arhefner/1802-Mini-PIO/README.md

# 1802-Mini-PIO
Parallel Expansion Board for the 1802/Mini Computer
