arhefner/1802-Mini-PIO/notes/1802-Mini-PIO-BOM.xlsx

Please refer to these notes as applicable for the parts list below:
*A | The Samtec 39 pin connector, when ordering from Digikey, will always show zero stock because they are made-to-order. They will ship same or next day though.
*B | These parts may be omitted if group port selection will not be used. See assembly notes.
*C | Use the long tail headers for stacked assembly, and the right-angle headers if installing on a base board with a group I/O cable
PARALLEL INTERFACE
Qty | Description |  | Manufacturer | Manufacturer # | Vendor | Vendor # | Price | Qty | Total
Integrated Circuits
2 | 74HC04 | U1,U8 | TI | SN74HC04N | Mouser | 595-SN74HC04N | 0.62 | 2.00 | 1.24
1 | 74HC00 | U2 | TI | SN74HC00N | Mouser | 595-SN74HC00N | 0.60 | 1.00 | 0.60
1 | 74HC238 | U3 | TI | CD74HC238E | Mouser | 595-CD74HC238E | 0.70 | 1.00 | 0.70
1 | 74HC11 | U4 | TI | SN74HC11N | Mouser | 595-SN74HC11N | 0.60 | 1.00 | 0.60
2 | 74HC273 | U5,U6 | TI | SN74HC273N | Mouser | 595-SN74HC273N | 0.93 | 2.00 | 1.86
1 | 74HC573 | U7 | TI | SN74HC573AN | Mouser | 595-SN74HC573AN | 0.94 | 1.00 | 0.94
2 | 74HC74 | U9,U11 | TI | SN74HC74N | Mouser | 595-SN74HC74N | 0.60 | 2.00 | 1.20
1 | 74HC08 | U10 | TI | SN74HC08N | Mouser | 595-SN74HC08N | 0.60 | 1.00 | 0.60
2 | 74HC4050 | U12,U13 | TI | CD74HC4050E | Mouser | 595-CD74HC4050E | 0.67 | 2.00 | 1.34
Discrete Components
8 | Diode 1N4148 | D1-D8 | ON Semi | 1N4148 | Mouser | 512-1N4148 | 0.10 | 8.00 | 0.80
13 | Ceramic capacitor 0.1uF radial 0.2" | C1-13 | Vishay | K104K10X7RF5UH5 | Digikey | BC2665CT-ND | 0.16 | 13.00 | 2.03
8 | Resistor 1/4 watt 22K | R1-R8 | Stackpole | CF14JT22K0 | Digikey | CF14JT22K0CT-ND | 0.10 | 8.00 | 0.80
2 | Resistor 1/4 watt 10K | R9,R10 | Stackpole | CF14JT10K0 | Digikey | CF14JT10K0CT-ND | 0.10 | 2.00 | 0.20
Interconnects
3 | R/A shrouded header 16 pins 0.1" | J11,J12,J13 | Hirose | HIF3FC-16PA-2.54DS(71) | Mouser | 798-HIF3FC16PA254DS1 | 2.50 | 3.00 | 7.50
2 | Straight header 3 pins 0.1" | JP1,JP2 | Sullins | PREC003SAAN-RC | Digikey | S1012EC-03-ND | 0.09 | 2.00 | 0.18
1 | Straight header 2 pins 0.1" | JP3 | Sullins | PREC002SAAN-RC | Digikey | S1012EC-02-ND | 0.06 | 1.00 | 0.06
1 | Straight dual row header 21 position (*B) | J7 | Sullins | PREC021DAAN-RC | Digikey | S2012EC-21-ND | 0.73 | 1.00 | 0.73
3 | Straight dual row header 7 position | J8,J9,J10 | Sullins | PREC007DAAN-RC | Digikey | S2012EC-07-ND | 0.31 | 3.00 | 0.93
5 | Jumper shunts 0.1" |  | Sullins | STC02SYAN | Digikey | S9000-ND | 0.09 | 5.00 | 0.45
1 | Socket 39 pin 0.1" long tail (*A)(*C) | J5 | Samtec | SSQ-139-03-T-S | Digikey | SAM1206-39-ND | 6.47 | 1.00 | 6.47
1 | Socket 20 pin 0.1" long tail (*B)(*C) | J6 | Samtec | SSQ-120-03-T-S | Digikey | SAM1206-20-ND | 3.46 | 1.00 | 3.46
1 | R/A header 39 pin 0.1" (*C) | J5 | Sullins | PREC039SBAN-M71RC | Digikey | S1112EC-39-ND | 0.88 | 1.00 | 0.88
1 | R/A header 20 pin 0.1" (*C) | J6 | Sullins | PREC020SBAN-M71RC | Digikey | S1112EC-20-ND | 0.50 | 1.00 | 0.50
Sockets
7 | DIP socket 14 pin 0.3" |  | On Shore | ED14DT | Digikey | ED3045-5-ND | 0.19 | 7.00 | 1.33
3 | DIP socket 16 pin 0.3" |  | On Shore | ED16DT | Digikey | ED3046-5-ND | 0.26 | 3.00 | 0.78
3 | DIP socket 20 pin 0.3" |  | On Shore | ED20DT | Digikey | ED3054-5-ND | 0.31 | 3.00 | 0.93
Mechanical
4 | 0.5 inch standoff spacer |  | RAF | 4505-440-AL-7 | Jameco | 393474 | 0.49 | 4.00 | 1.96
1 | Circuit Board |  | Hefner |  | JLCPCB |  | 0.40 | 1.00 | 0.40
 |  |  |  |  |  |  | Total |  | 39.47
