arhefner/1802-Mini-PIO/notes/1802-Mini-PIO.pdf

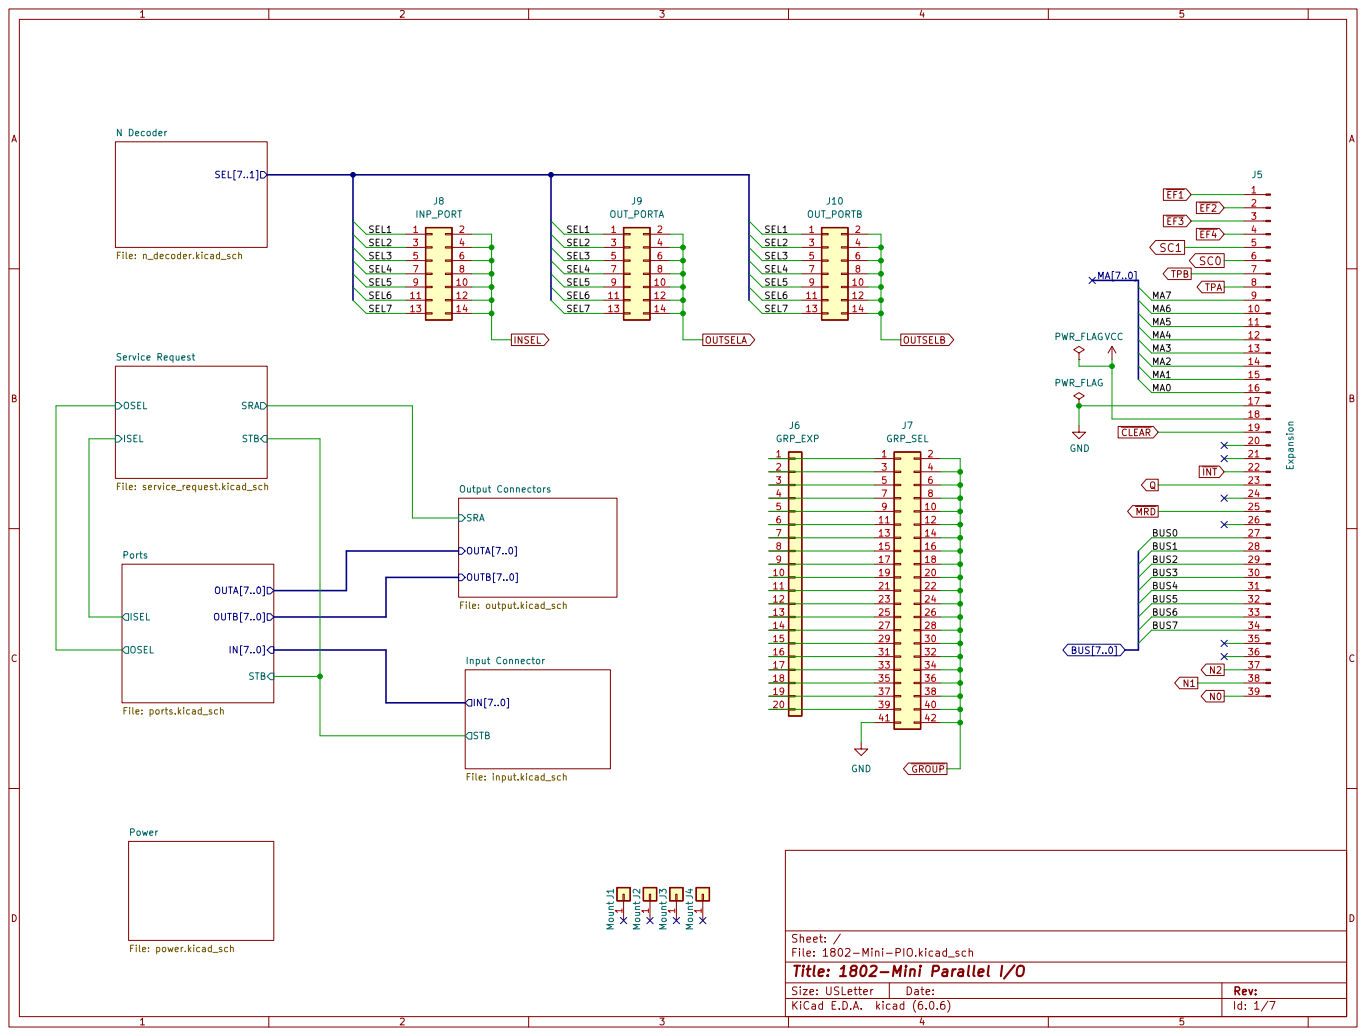
[picture p1: page 1]

1 J2 Mount 1 J3 Mount 1 J1 Mount 1 J4 Mount 1
File: input.kicad_sch SRA OUTB[7..0]

File: 1802-Mini-PIO.kicad_sch Sheet: / STB

Id: 1/7 Title: 1802-Mini Parallel I/O

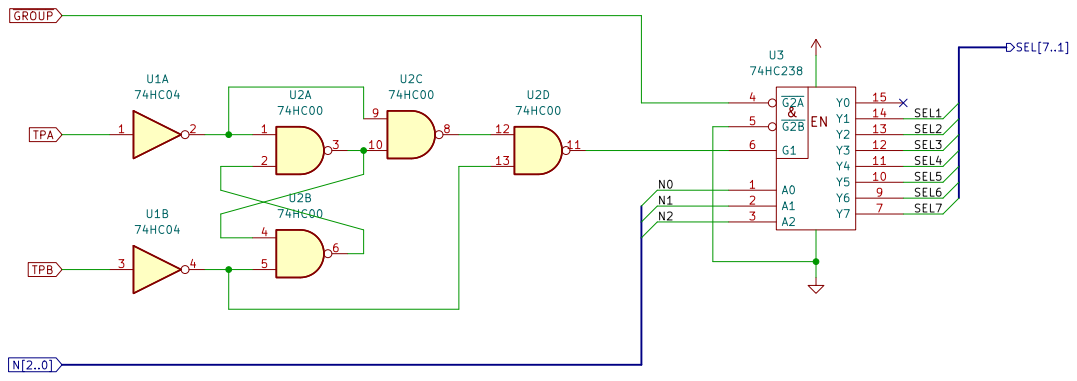
[picture p2: page 2]

File: n_decoder.kicad_sch Sheet: /N Decoder/
Id: 2/7 Title: 1802-Mini Parallel I/O

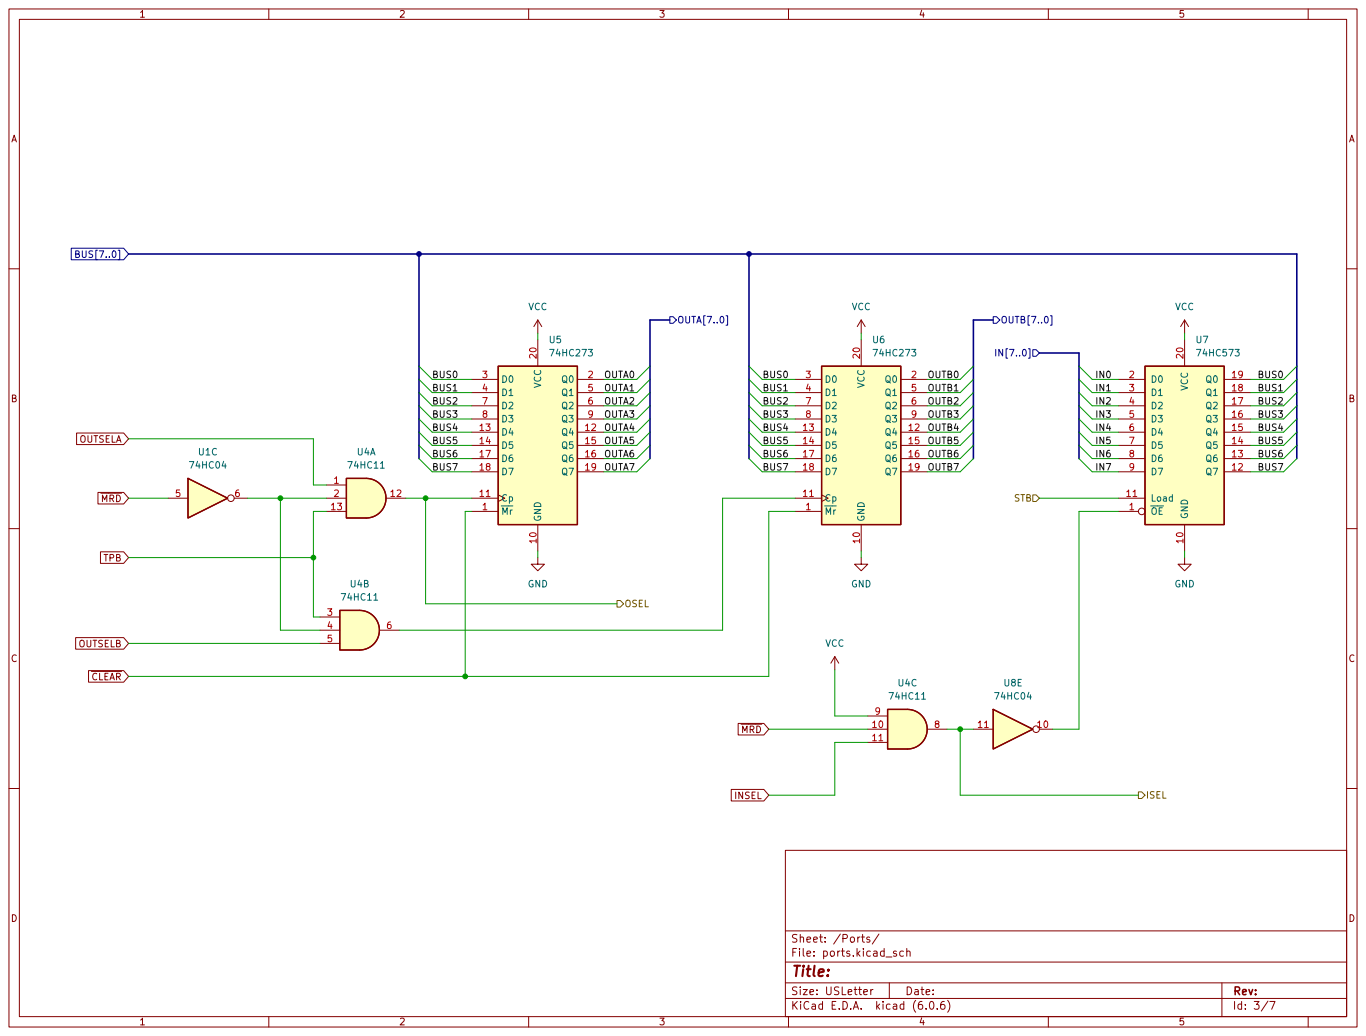
[picture p3: page 3]

File: ports.kicad_sch Sheet: /Ports/

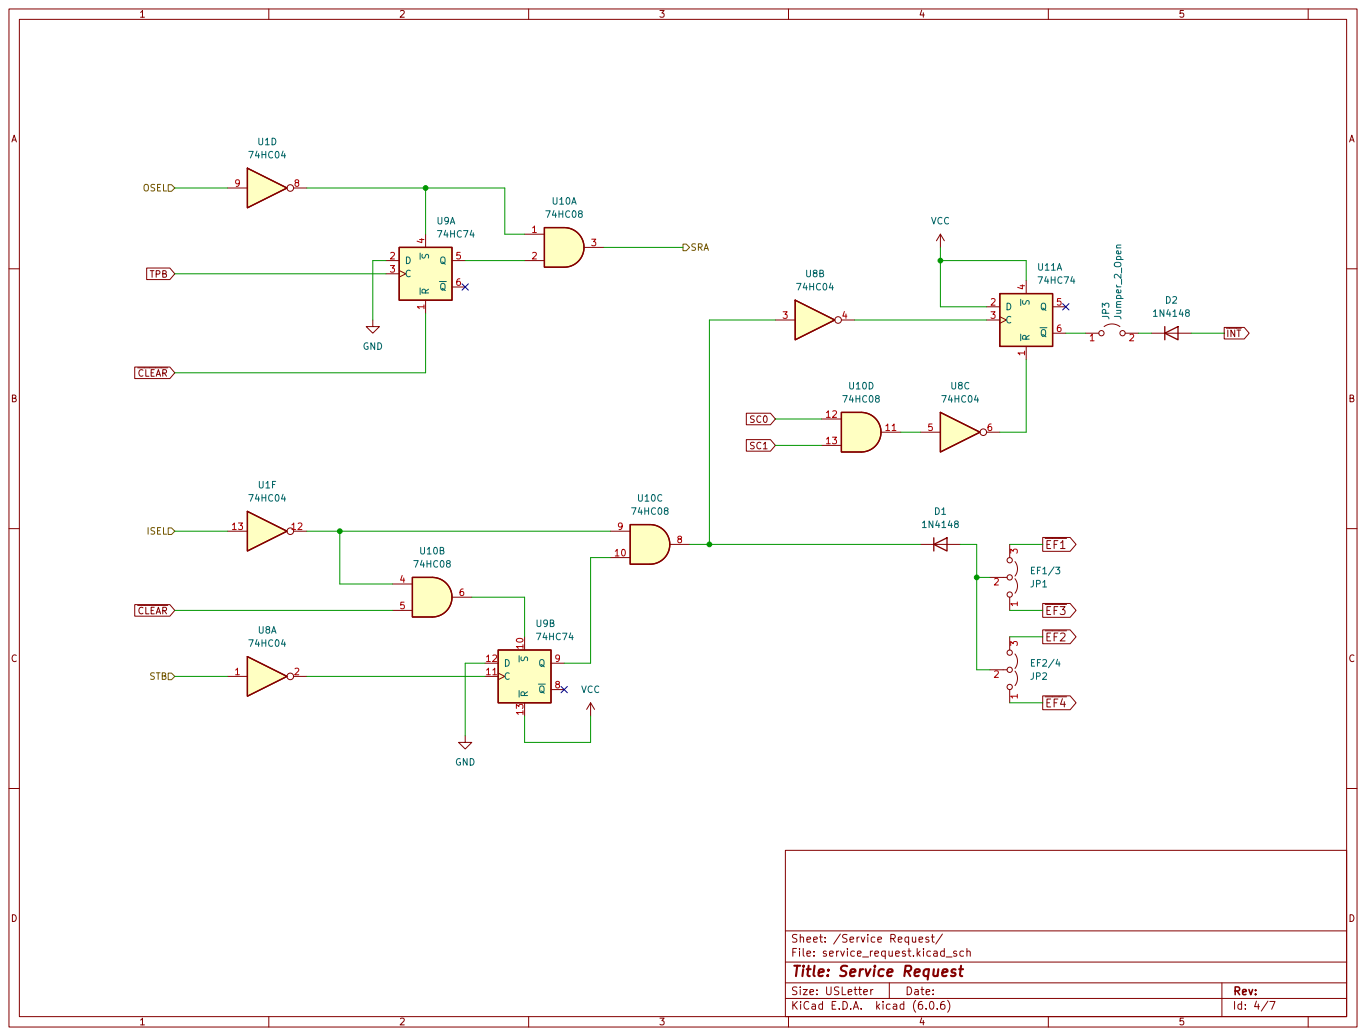
[picture p4: page 4]

Sheet: /Service Request/
File: service_request.kicad_sch
Id: 4/7 Title: Service Request

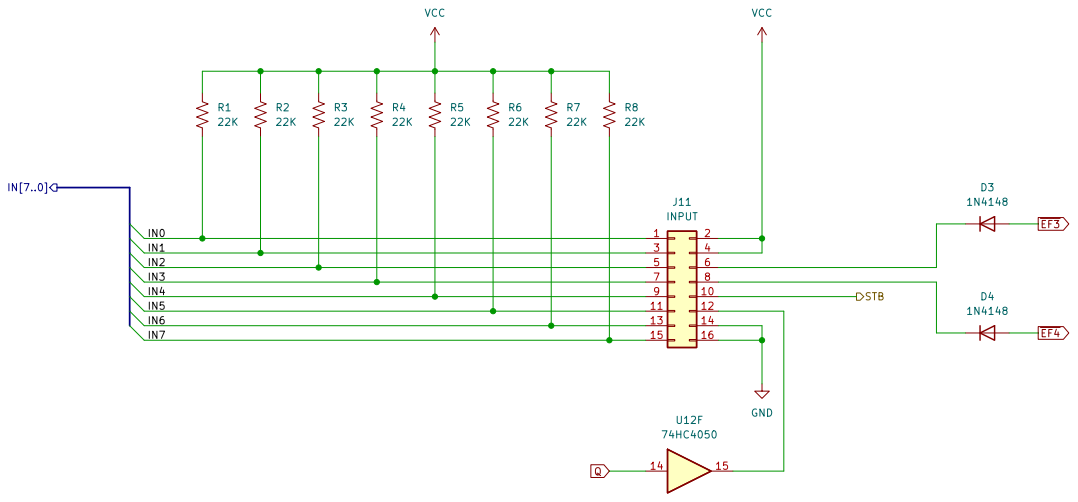
[picture p5: page 5]

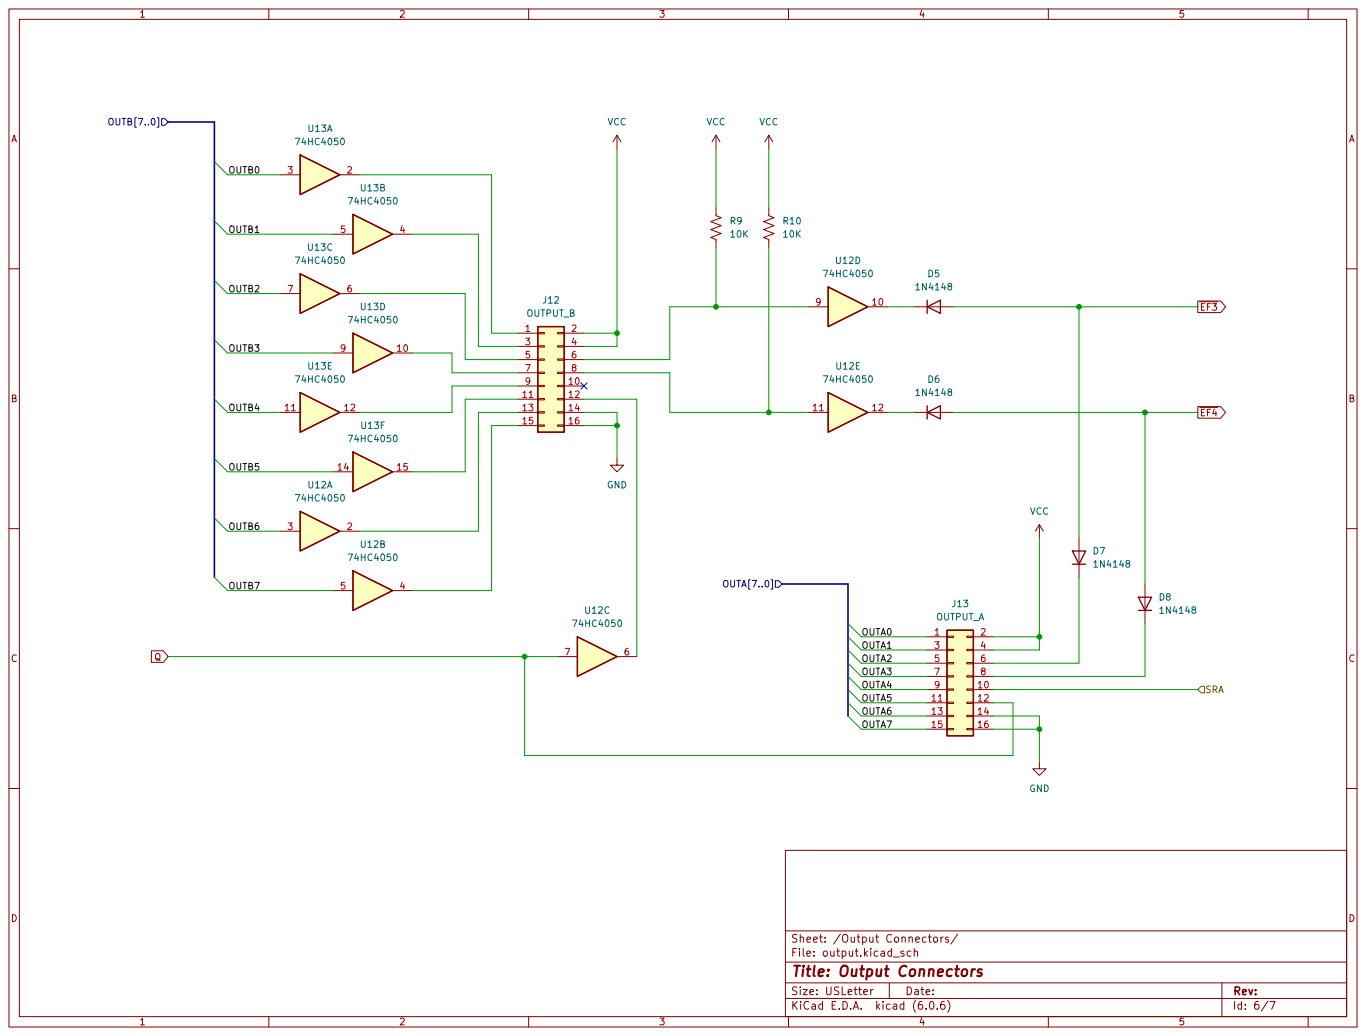
[picture p6: page 6]

13 | 14
15 | 16

File: output.kicad_sch
Id: 6/7 Title: Output Connectors

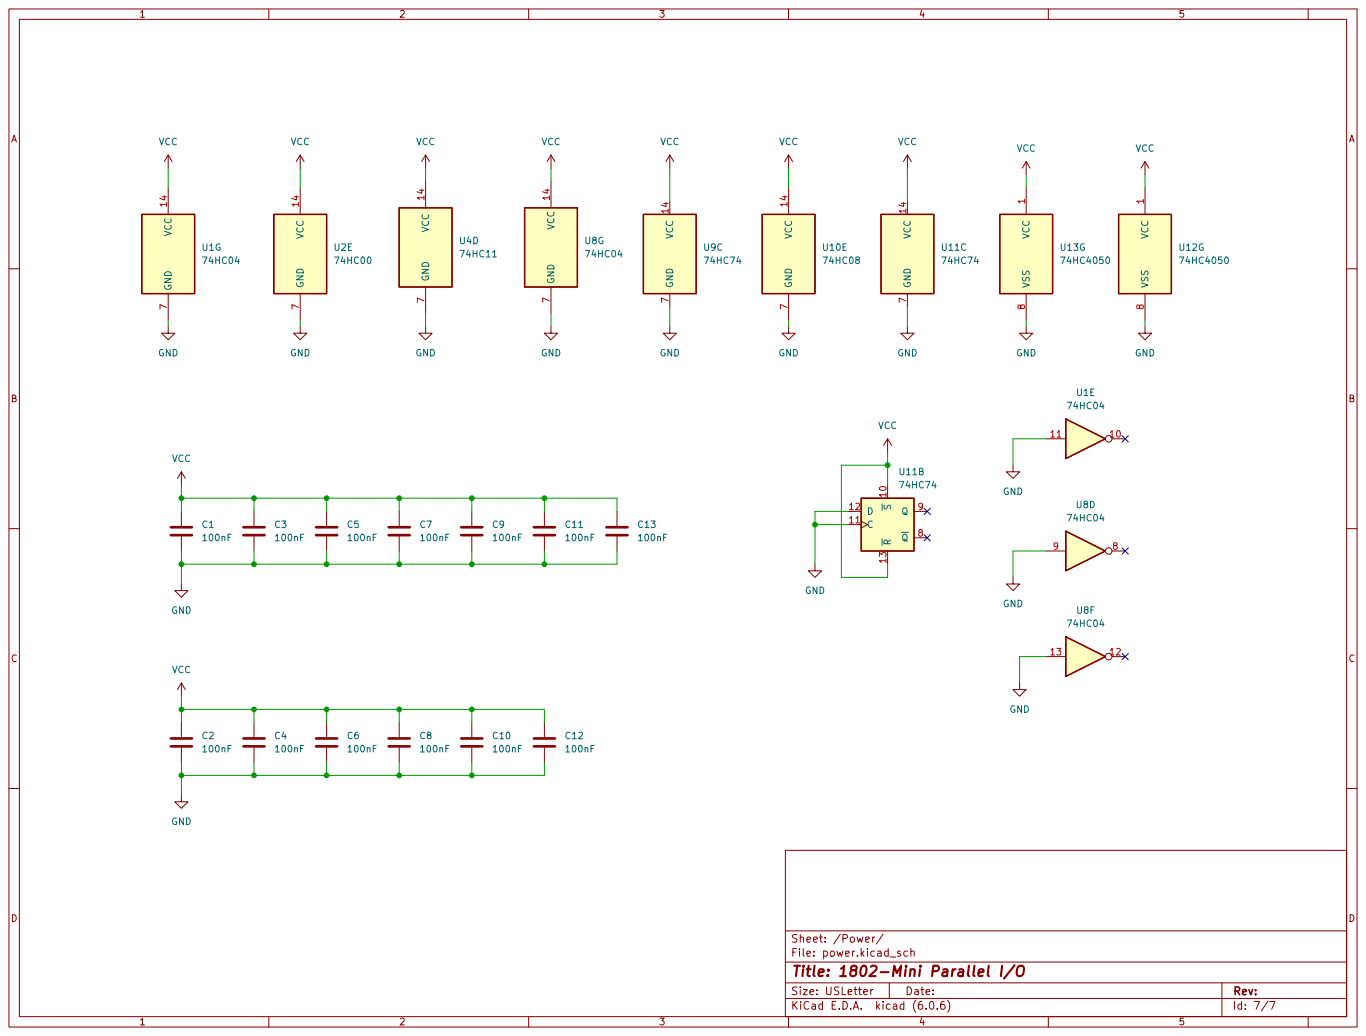
[picture p7: page 7]

File: power.kicad_sch Sheet: /Power/ C1

Id: 7/7 Title: 1802-Mini Parallel I/O
