arhefner/1802-Mini-PIO/1802-Mini-PIO.kicad_pcb

## KiCad design 1802-Mini-PIO.kicad_pcb (2023-04-30)

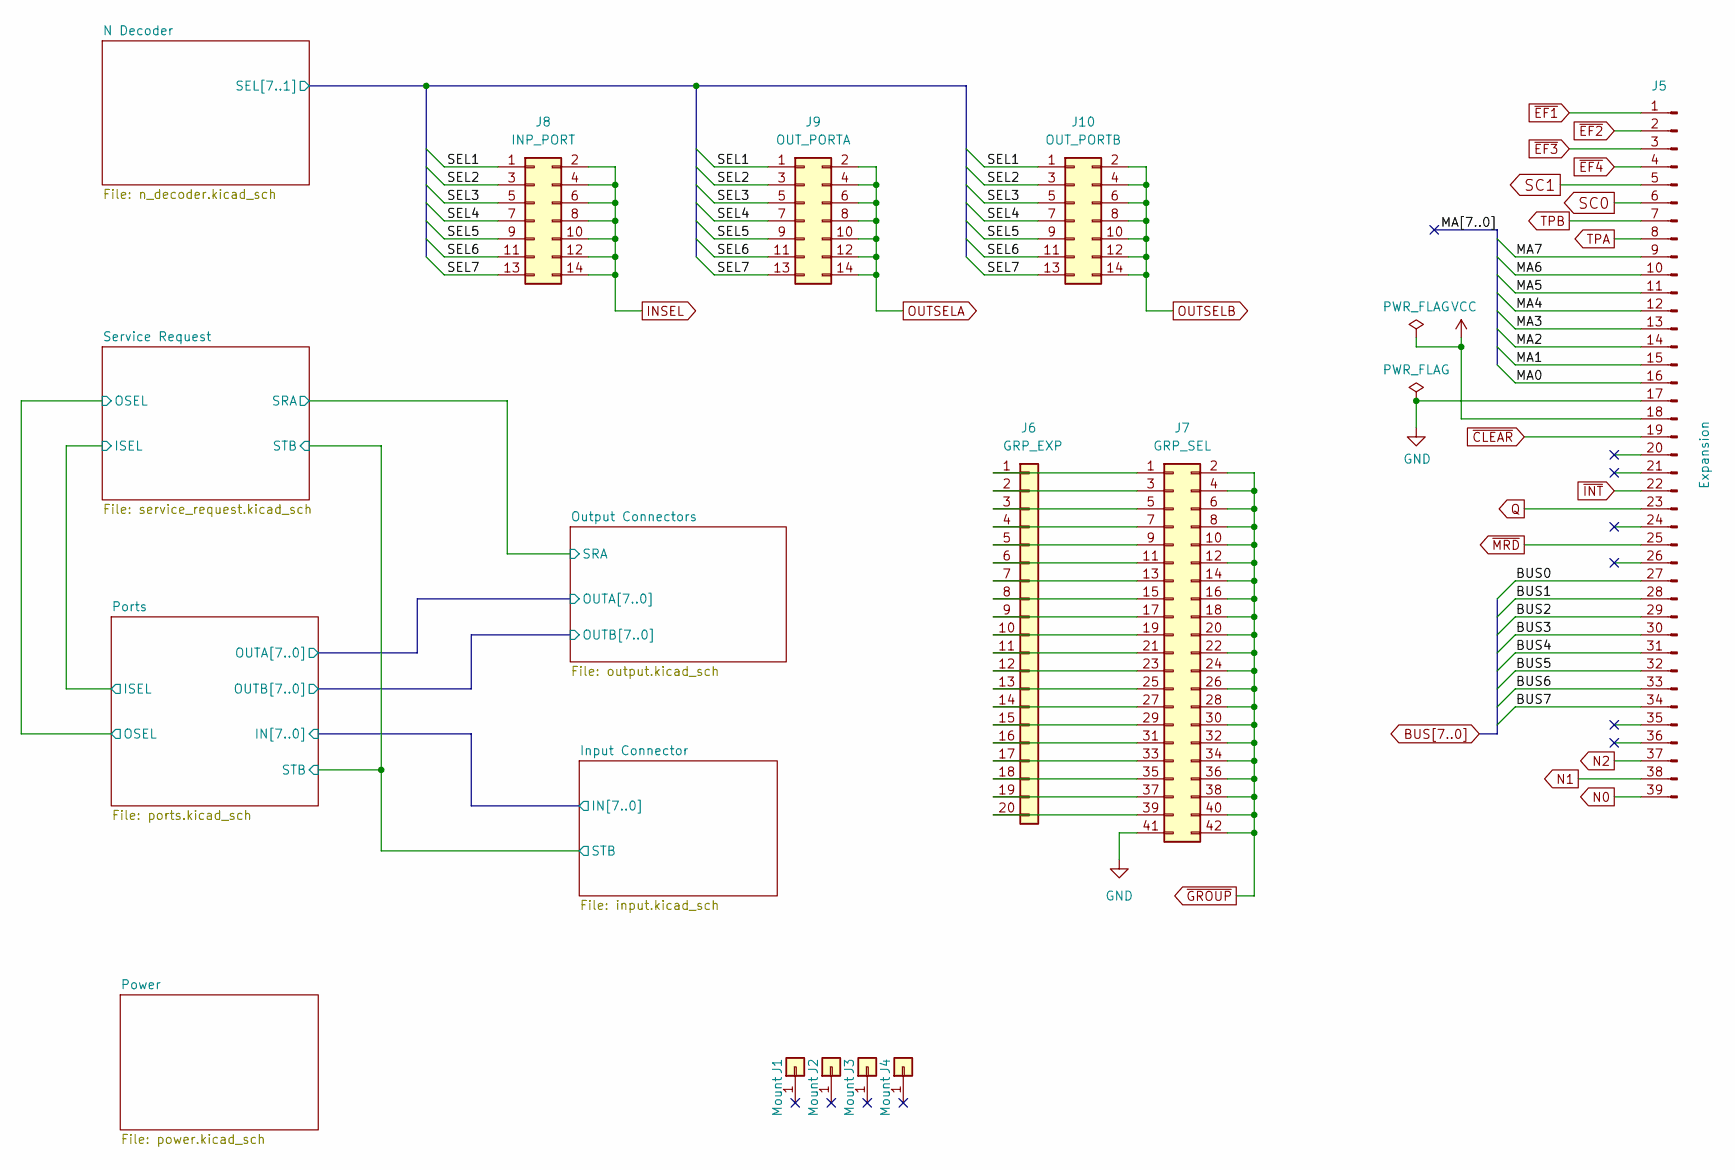
[picture p8: schematic 1802-Mini-PIO.kicad_sch, 1802-Mini Parallel I/O]

Parts:
J1, J2, J3, J4: Mount; 1pin
J5: Expansion; Pin_Header_Straight_1x39_Pitch2.54mm
J6: GRP_EXP; PinHeader_1x20_P2.54mm_Vertical
J7: GRP_SEL; PinHeader_2x21_P2.54mm_Vertical
J8: INP_PORT; PinHeader_2x07_P2.54mm_Vertical
J9: OUT_PORTA; PinHeader_2x07_P2.54mm_Vertical
J10: OUT_PORTB; PinHeader_2x07_P2.54mm_Vertical

Connections:
/MA0: J5.16
/MA1: J5.15
/MA2: J5.14
/MA3: J5.13
/MA4: J5.12
/MA5: J5.11
/MA6: J5.10
/MA7: J5.9
/N Decoder/SEL1: J8.1, J9.1, J10.1; also elsewhere on the board
/N Decoder/SEL2: J8.3, J9.3, J10.3; also elsewhere on the board
/N Decoder/SEL3: J8.5, J9.5, J10.5; also elsewhere on the board
/N Decoder/SEL4: J8.7, J9.7, J10.7; also elsewhere on the board
/N Decoder/SEL5: J8.9, J9.9, J10.9; also elsewhere on the board
/N Decoder/SEL6: J8.11, J9.11, J10.11; also elsewhere on the board
/N Decoder/SEL7: J8.13, J9.13, J10.13; also elsewhere on the board
BUS0: J5.27; also elsewhere on the board
BUS1: J5.28; also elsewhere on the board
BUS2: J5.29; also elsewhere on the board
BUS3: J5.30; also elsewhere on the board
BUS4: J5.31; also elsewhere on the board
BUS5: J5.32; also elsewhere on the board
BUS6: J5.33; also elsewhere on the board
BUS7: J5.34; also elsewhere on the board
INSEL: J8.2, J8.4, J8.6, J8.8, J8.10, J8.12, J8.14; also elsewhere on the board
N0: J5.39; also elsewhere on the board
N1: J5.38; also elsewhere on the board
N2: J5.37; also elsewhere on the board
unnamed: J6.1, J7.1
unnamed: J6.2, J7.3
unnamed: J6.3, J7.5
unnamed: J6.4, J7.7
unnamed: J6.5, J7.9
unnamed: J6.6, J7.11
unnamed: J6.7, J7.13
unnamed: J6.8, J7.15
unnamed: J6.9, J7.17
unnamed: J6.10, J7.19
unnamed: J6.11, J7.21
unnamed: J6.12, J7.23
unnamed: J6.13, J7.25
unnamed: J6.14, J7.27
unnamed: J6.15, J7.29
unnamed: J6.16, J7.31
unnamed: J6.17, J7.33
unnamed: J6.18, J7.35
unnamed: J6.19, J7.37
unnamed: J6.20, J7.39
OUTSELA: J9.2, J9.4, J9.6, J9.8, J9.10, J9.12, J9.14; also elsewhere on the board
OUTSELB: J10.2, J10.4, J10.6, J10.8, J10.10, J10.12, J10.14; also elsewhere on the board
Q: J5.23; also elsewhere on the board
SC0: J5.6; also elsewhere on the board
SC1: J5.5; also elsewhere on the board
TPA: J5.8; also elsewhere on the board
TPB: J5.7; also elsewhere on the board
~CLEAR: J5.19; also elsewhere on the board
~EF1: J5.1; also elsewhere on the board
~EF2: J5.2; also elsewhere on the board
~EF3: J5.3; also elsewhere on the board
~EF4: J5.4; also elsewhere on the board
~GROUP: J7.2, J7.4, J7.6, J7.8, J7.10, J7.12, J7.14, J7.16, J7.18, J7.20, J7.22, J7.24, J7.26, J7.28, J7.30, J7.32, J7.34, J7.36, J7.38, J7.40, J7.42; also elsewhere on the board
~INT: J5.22; also elsewhere on the board
~MRD: J5.25; also elsewhere on the board

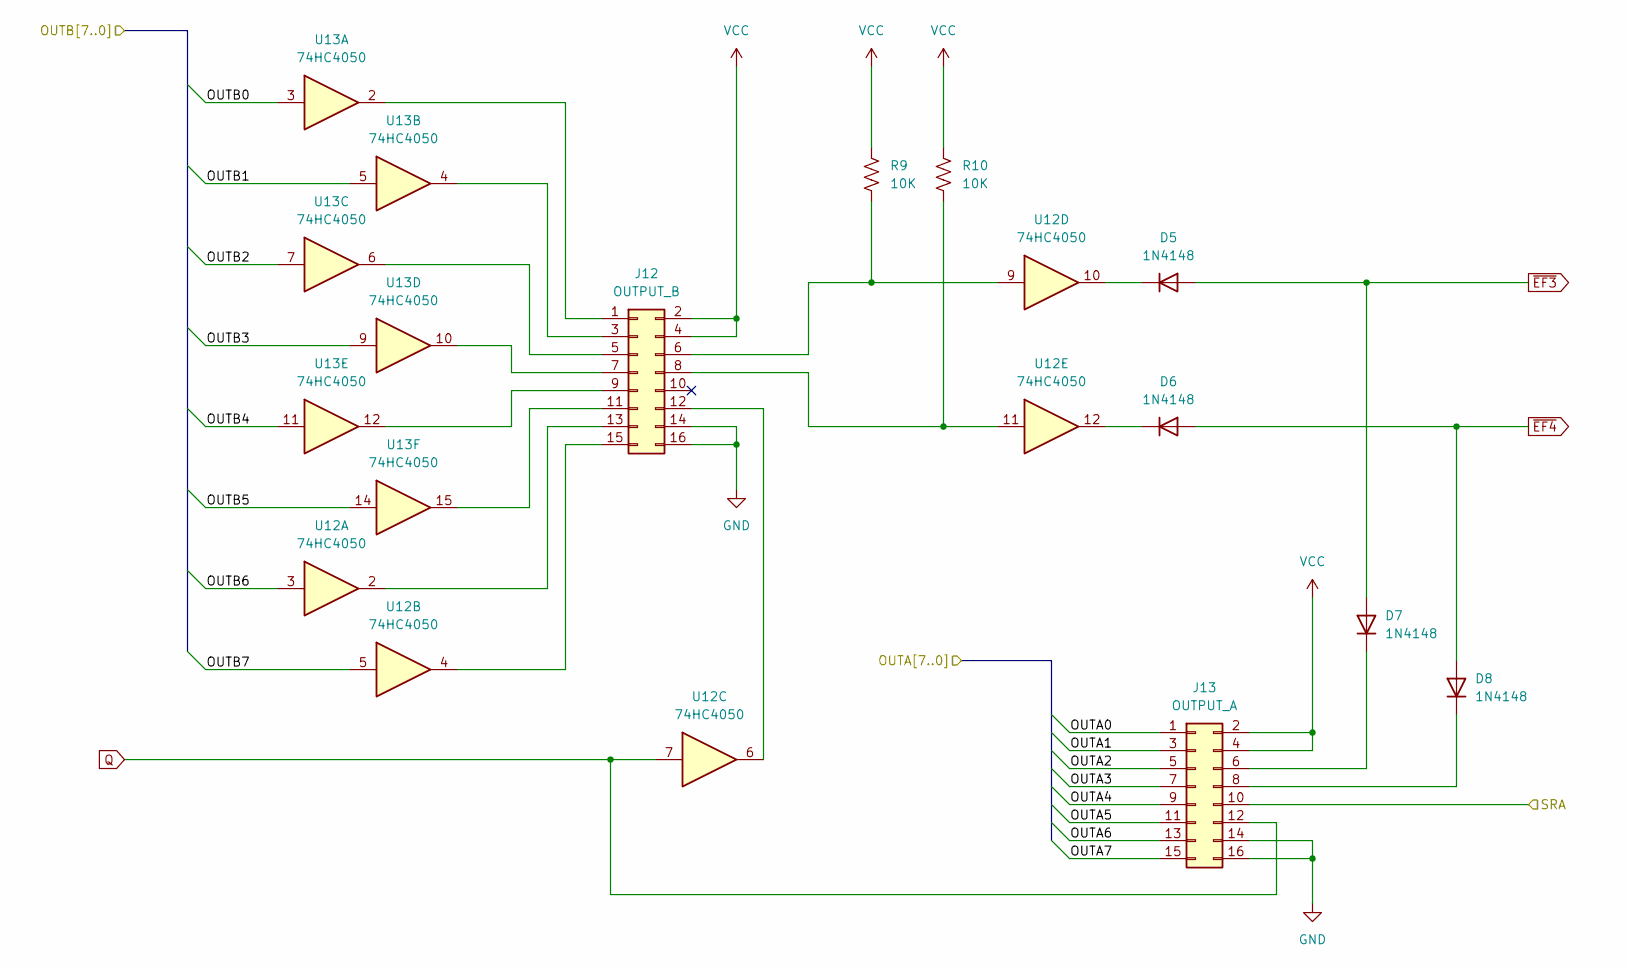
[picture p9: schematic output.kicad_sch, Output Connectors]

Parts:
D5, D6, D7, D8: 1N4148; D_DO-35_SOD27_P7.62mm_Horizontal
J12: OUTPUT_B; PinHeader_2x08_P2.54mm_Vertical
J13: OUTPUT_A; PinHeader_2x08_P2.54mm_Vertical
R9, R10: 10K; R_Axial_DIN0207_L6.3mm_D2.5mm_P10.16mm_Horizontal
U12, U13: 74HC4050; DIP-16_W7.62mm_Socket

Connections:
/Output Connectors/OUTA0: J13.1; also elsewhere on the board
/Output Connectors/OUTA1: J13.3; also elsewhere on the board
/Output Connectors/OUTA2: J13.5; also elsewhere on the board
/Output Connectors/OUTA3: J13.7; also elsewhere on the board
/Output Connectors/OUTA4: J13.9; also elsewhere on the board
/Output Connectors/OUTA5: J13.11; also elsewhere on the board
/Output Connectors/OUTA6: J13.13; also elsewhere on the board
/Output Connectors/OUTA7: J13.15; also elsewhere on the board
/Output Connectors/OUTB0: U13.3; also elsewhere on the board
/Output Connectors/OUTB1: U13.5; also elsewhere on the board
/Output Connectors/OUTB2: U13.7; also elsewhere on the board
/Output Connectors/OUTB3: U13.9; also elsewhere on the board
/Output Connectors/OUTB4: U13.11; also elsewhere on the board
/Output Connectors/OUTB5: U13.14; also elsewhere on the board
/Output Connectors/OUTB6: U12.3; also elsewhere on the board
/Output Connectors/OUTB7: U12.5; also elsewhere on the board
/Output Connectors/SRA: J13.10; also elsewhere on the board
unnamed: D5.1 (K), U12.10
unnamed: D6.1 (K), U12.12
unnamed: D7.1 (K), J13.6
unnamed: D8.1 (K), J13.8
unnamed: J12.1, U13.2
unnamed: J12.3, U13.4
unnamed: J12.5, U13.6
unnamed: J12.6, R9.2, U12.9
unnamed: J12.7, U13.10
unnamed: J12.8, R10.2, U12.11
unnamed: J12.9, U13.12
unnamed: J12.11, U13.15
unnamed: J12.12, U12.6
unnamed: J12.13, U12.2
unnamed: J12.15, U12.4
Q: J13.12, U12.7; also elsewhere on the board
~EF3: D5.2 (A), D7.2 (A); also elsewhere on the board
~EF4: D6.2 (A), D8.2 (A); also elsewhere on the board

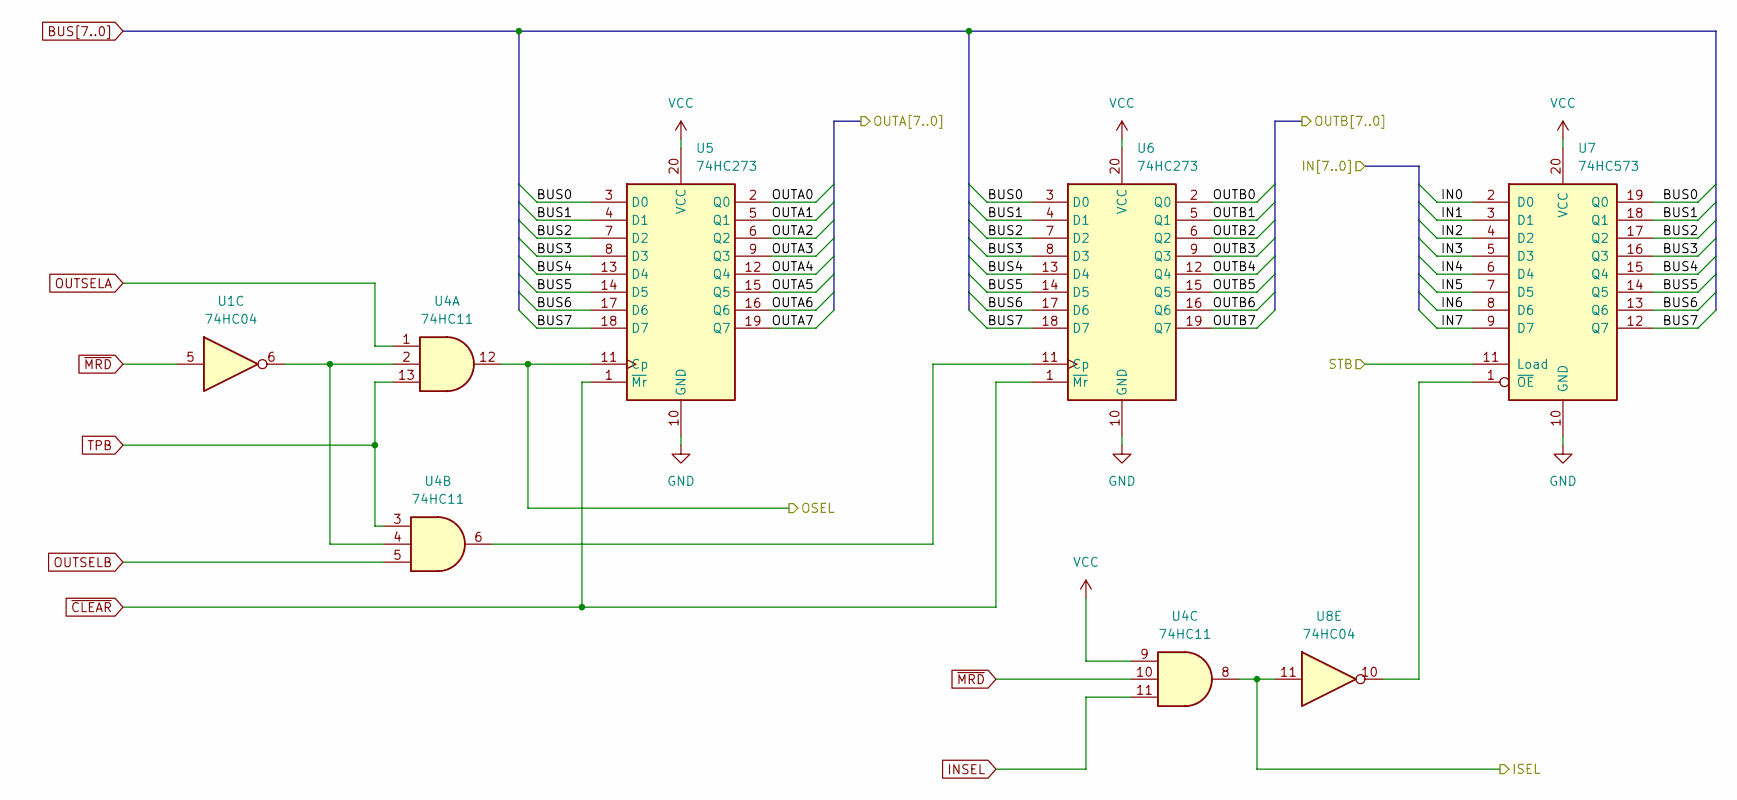
[picture p10: schematic ports.kicad_sch]

Parts:
U1, U8: 74HC04; DIP-14_W7.62mm_Socket
U4: 74HC11; DIP-14_W7.62mm_Socket
U5, U6: 74HC273; DIP-20_W7.62mm_Socket
U7: 74HC573; DIP-20_W7.62mm_Socket

Connections:
/Input Connector/IN0: U7.2 (D0); also elsewhere on the board
/Input Connector/IN1: U7.3 (D1); also elsewhere on the board
/Input Connector/IN2: U7.4 (D2); also elsewhere on the board
/Input Connector/IN3: U7.5 (D3); also elsewhere on the board
/Input Connector/IN4: U7.6 (D4); also elsewhere on the board
/Input Connector/IN5: U7.7 (D5); also elsewhere on the board
/Input Connector/IN6: U7.8 (D6); also elsewhere on the board
/Input Connector/IN7: U7.9 (D7); also elsewhere on the board
/Input Connector/STB: U7.11 (Load); also elsewhere on the board
/Output Connectors/OUTA0: U5.2 (Q0); also elsewhere on the board
/Output Connectors/OUTA1: U5.5 (Q1); also elsewhere on the board
/Output Connectors/OUTA2: U5.6 (Q2); also elsewhere on the board
/Output Connectors/OUTA3: U5.9 (Q3); also elsewhere on the board
/Output Connectors/OUTA4: U5.12 (Q4); also elsewhere on the board
/Output Connectors/OUTA5: U5.15 (Q5); also elsewhere on the board
/Output Connectors/OUTA6: U5.16 (Q6); also elsewhere on the board
/Output Connectors/OUTA7: U5.19 (Q7); also elsewhere on the board
/Output Connectors/OUTB0: U6.2 (Q0); also elsewhere on the board
/Output Connectors/OUTB1: U6.5 (Q1); also elsewhere on the board
/Output Connectors/OUTB2: U6.6 (Q2); also elsewhere on the board
/Output Connectors/OUTB3: U6.9 (Q3); also elsewhere on the board
/Output Connectors/OUTB4: U6.12 (Q4); also elsewhere on the board
/Output Connectors/OUTB5: U6.15 (Q5); also elsewhere on the board
/Output Connectors/OUTB6: U6.16 (Q6); also elsewhere on the board
/Output Connectors/OUTB7: U6.19 (Q7); also elsewhere on the board
/Ports/ISEL: U4.8, U8.11; also elsewhere on the board
/Ports/OSEL: U4.12, U5.11 (Cp); also elsewhere on the board
BUS0: U5.3 (D0), U6.3 (D0), U7.19 (Q0); also elsewhere on the board
BUS1: U5.4 (D1), U6.4 (D1), U7.18 (Q1); also elsewhere on the board
BUS2: U5.7 (D2), U6.7 (D2), U7.17 (Q2); also elsewhere on the board
BUS3: U5.8 (D3), U6.8 (D3), U7.16 (Q3); also elsewhere on the board
BUS4: U5.13 (D4), U6.13 (D4), U7.15 (Q4); also elsewhere on the board
BUS5: U5.14 (D5), U6.14 (D5), U7.14 (Q5); also elsewhere on the board
BUS6: U5.17 (D6), U6.17 (D6), U7.13 (Q6); also elsewhere on the board
BUS7: U5.18 (D7), U6.18 (D7), U7.12 (Q7); also elsewhere on the board
INSEL: U4.11; also elsewhere on the board
unnamed: U1.6, U4.2, U4.4
unnamed: U4.6, U6.11 (Cp)
unnamed: U7.1 (~OE), U8.10
OUTSELA: U4.1; also elsewhere on the board
OUTSELB: U4.5; also elsewhere on the board
TPB: U4.3, U4.13; also elsewhere on the board
~CLEAR: U5.1 (~Mr), U6.1 (~Mr); also elsewhere on the board
~MRD: U1.5, U4.10; also elsewhere on the board

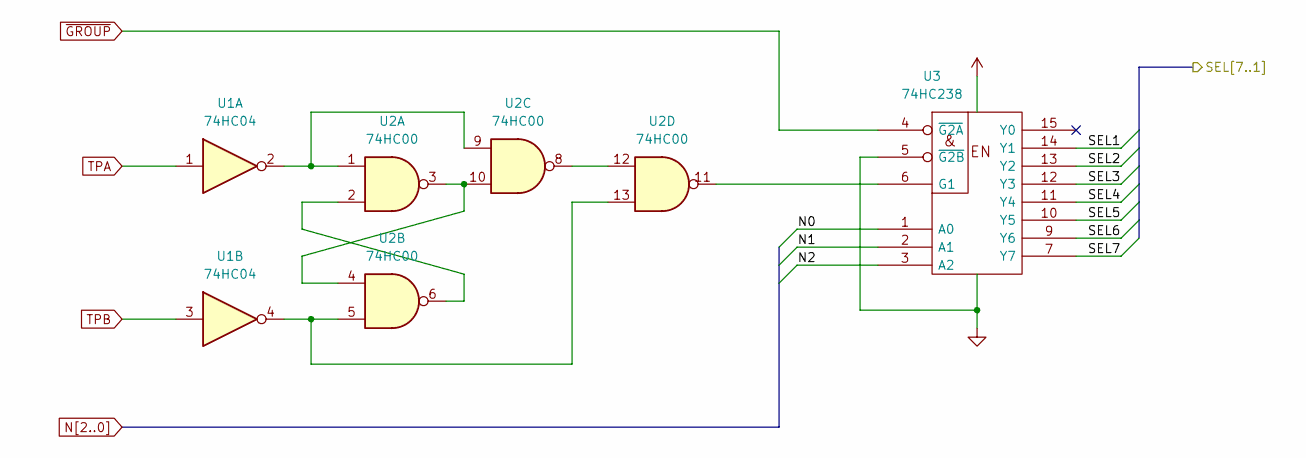
[picture p11: schematic n_decoder.kicad_sch, 1802-Mini Parallel I/O]

Parts:
U1: 74HC04; DIP-14_W7.62mm_Socket
U2: 74HC00; DIP-14_W7.62mm_Socket
U3: 74HC238; DIP-16_W7.62mm_Socket

Connections:
/N Decoder/SEL1: U3.14 (Y1); also elsewhere on the board
/N Decoder/SEL2: U3.13 (Y2); also elsewhere on the board
/N Decoder/SEL3: U3.12 (Y3); also elsewhere on the board
/N Decoder/SEL4: U3.11 (Y4); also elsewhere on the board
/N Decoder/SEL5: U3.10 (Y5); also elsewhere on the board
/N Decoder/SEL6: U3.9 (Y6); also elsewhere on the board
/N Decoder/SEL7: U3.7 (Y7); also elsewhere on the board
N0: U3.1 (A0); also elsewhere on the board
N1: U3.2 (A1); also elsewhere on the board
N2: U3.3 (A2); also elsewhere on the board
unnamed: U1.2, U2.1, U2.9
unnamed: U1.4, U2.5, U2.13
unnamed: U2.2, U2.6
unnamed: U2.3, U2.4, U2.10
unnamed: U2.11, U3.6 (G1)
unnamed: U2.8, U2.12
TPA: U1.1; also elsewhere on the board
TPB: U1.3; also elsewhere on the board
~GROUP: U3.4 (~G2A); also elsewhere on the board

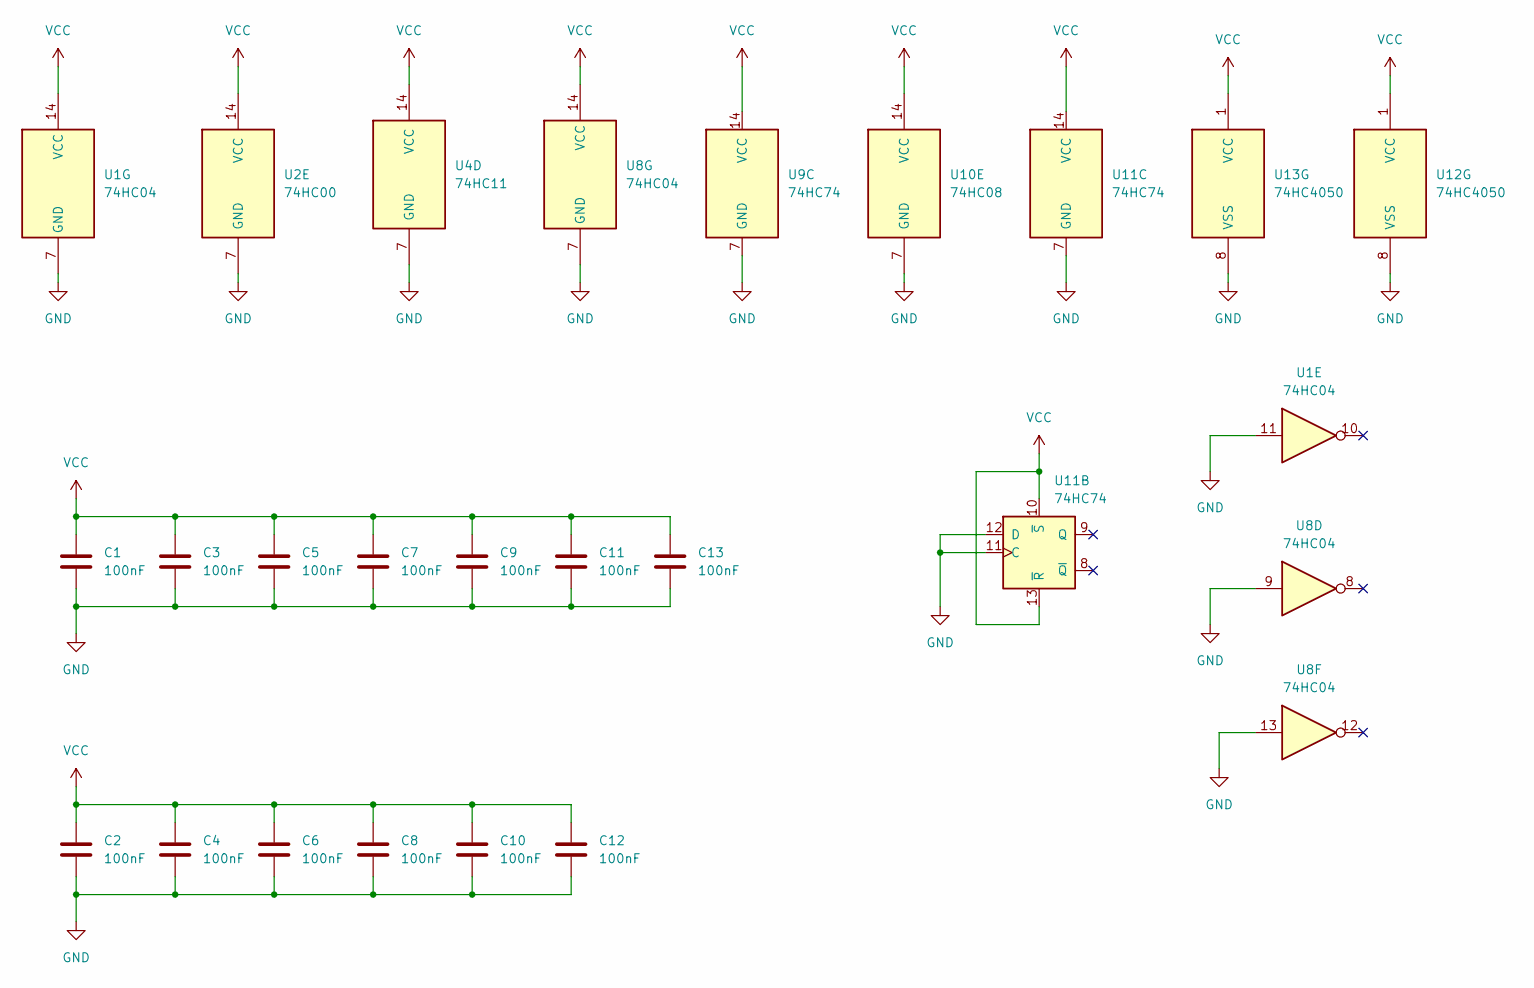
[picture p12: schematic power.kicad_sch, 1802-Mini Parallel I/O]

Parts:
C1, C2, C3, C4, C5, C6, C7, C8, C9, C10, C11, C12, C13: 100nF; C_Disc_D4.7mm_W2.5mm_P5.00mm
U1, U8: 74HC04; DIP-14_W7.62mm_Socket
U2: 74HC00; DIP-14_W7.62mm_Socket
U4: 74HC11; DIP-14_W7.62mm_Socket
U9, U11: 74HC74; DIP-14_W7.62mm_Socket
U10: 74HC08; DIP-14_W7.62mm_Socket
U12, U13: 74HC4050; DIP-16_W7.62mm_Socket

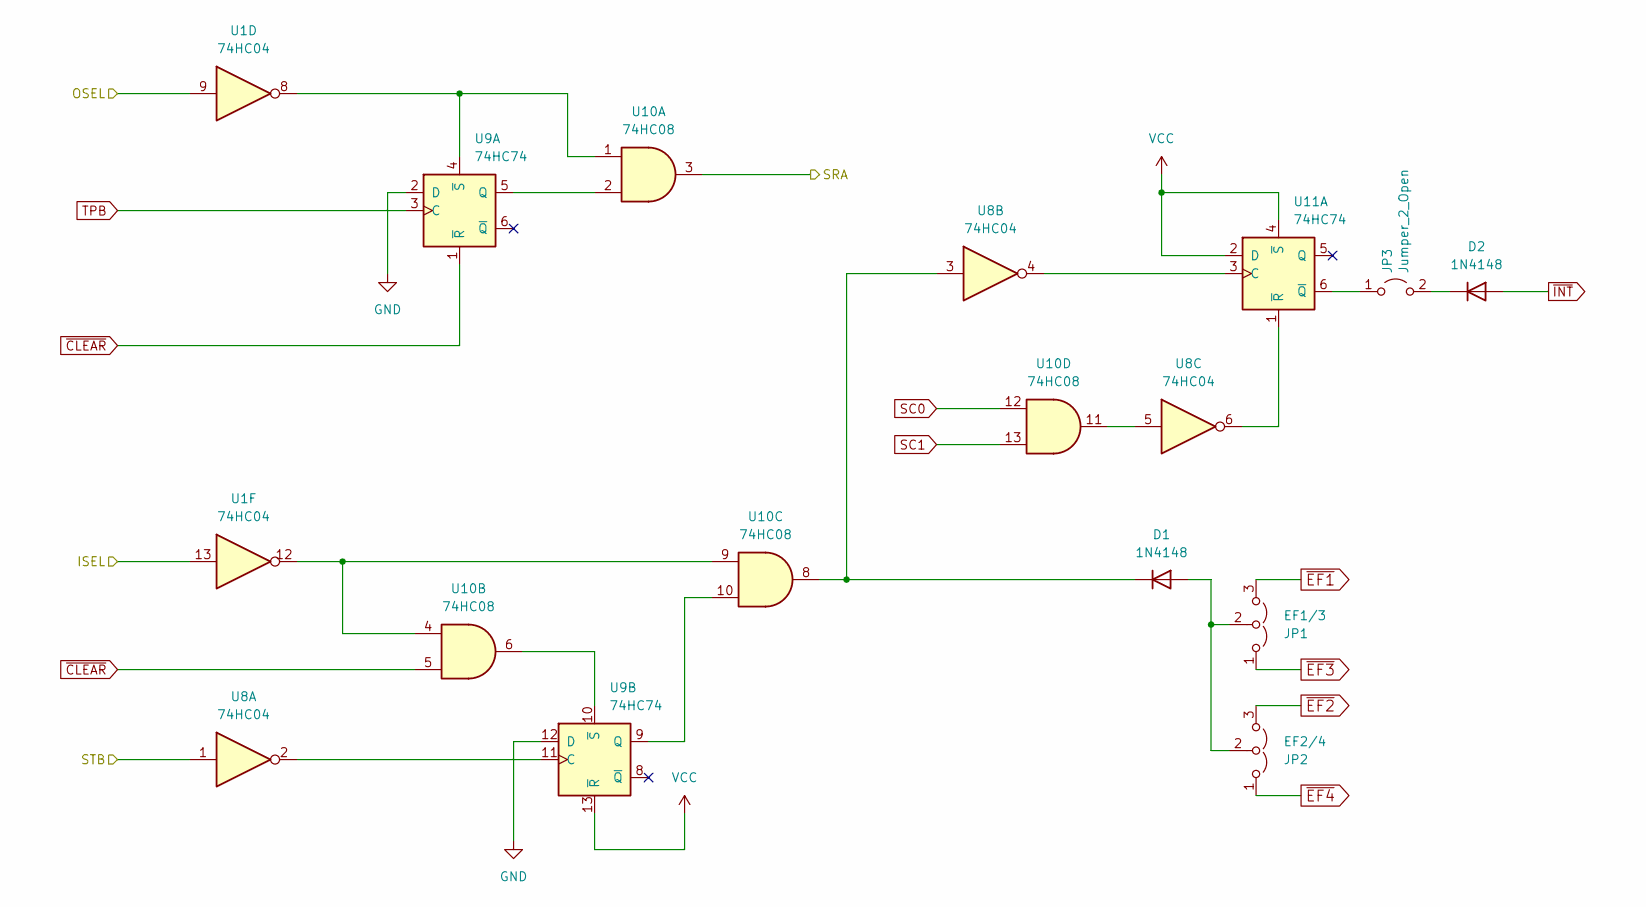
[picture p13: schematic service_request.kicad_sch, Service Request]

Parts:
D1, D2: 1N4148; D_DO-35_SOD27_P7.62mm_Horizontal
JP1: EF1/3; PinHeader_1x03_P2.54mm_Vertical
JP2: EF2/4; PinHeader_1x03_P2.54mm_Vertical
JP3: Jumper_2_Open; PinHeader_1x02_P2.54mm_Vertical
U1, U8: 74HC04; DIP-14_W7.62mm_Socket
U9, U11: 74HC74; DIP-14_W7.62mm_Socket
U10: 74HC08; DIP-14_W7.62mm_Socket

Connections:
/Input Connector/STB: U8.1; also elsewhere on the board
/Output Connectors/SRA: U10.3; also elsewhere on the board
/Ports/ISEL: U1.13; also elsewhere on the board
/Ports/OSEL: U1.9; also elsewhere on the board
unnamed: D1.1 (K), U8.3, U10.8
unnamed: D1.2 (A), JP1.2 (C), JP2.2 (C)
unnamed: D2.1 (K), JP3.2 (B)
unnamed: JP3.1 (A), U11.6 (~Q)
unnamed: U1.8, U9.4 (~S), U10.1
unnamed: U1.12, U10.4, U10.9
unnamed: U8.2, U9.11 (C)
unnamed: U9.5 (Q), U10.2
unnamed: U9.10 (~S), U10.6
unnamed: U9.9 (Q), U10.10
unnamed: U8.5, U10.11
unnamed: U8.6, U11.1 (~R)
unnamed: U8.4, U11.3 (C)
SC0: U10.12; also elsewhere on the board
SC1: U10.13; also elsewhere on the board
TPB: U9.3 (C); also elsewhere on the board
~CLEAR: U9.1 (~R), U10.5; also elsewhere on the board
~EF1: JP1.3 (B); also elsewhere on the board
~EF2: JP2.3 (B); also elsewhere on the board
~EF3: JP1.1 (A); also elsewhere on the board
~EF4: JP2.1 (A); also elsewhere on the board
~INT: D2.2 (A); also elsewhere on the board

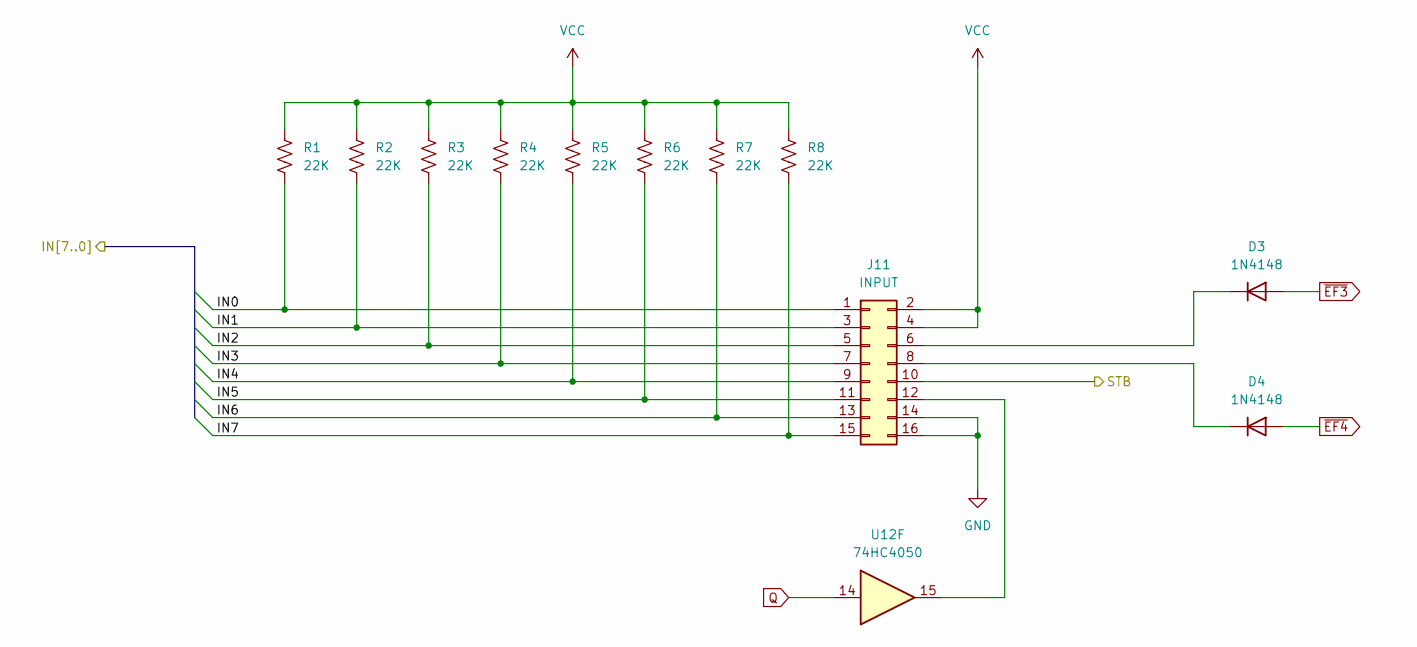
[picture p14: schematic input.kicad_sch]

Parts:
D3, D4: 1N4148; D_DO-35_SOD27_P7.62mm_Horizontal
J11: INPUT; PinHeader_2x08_P2.54mm_Vertical
R1, R2, R3, R4, R5, R6, R7, R8: 22K; R_Axial_DIN0207_L6.3mm_D2.5mm_P10.16mm_Horizontal
U12: 74HC4050; DIP-16_W7.62mm_Socket

Connections:
/Input Connector/IN0: J11.1, R1.2; also elsewhere on the board
/Input Connector/IN1: J11.3, R2.2; also elsewhere on the board
/Input Connector/IN2: J11.5, R3.2; also elsewhere on the board
/Input Connector/IN3: J11.7, R4.2; also elsewhere on the board
/Input Connector/IN4: J11.9, R5.2; also elsewhere on the board
/Input Connector/IN5: J11.11, R6.2; also elsewhere on the board
/Input Connector/IN6: J11.13, R7.2; also elsewhere on the board
/Input Connector/IN7: J11.15, R8.2; also elsewhere on the board
/Input Connector/STB: J11.10; also elsewhere on the board
unnamed: D3.1 (K), J11.6
unnamed: D4.1 (K), J11.8
unnamed: J11.12, U12.15
Q: U12.14; also elsewhere on the board
~EF3: D3.2 (A); also elsewhere on the board
~EF4: D4.2 (A); also elsewhere on the board

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
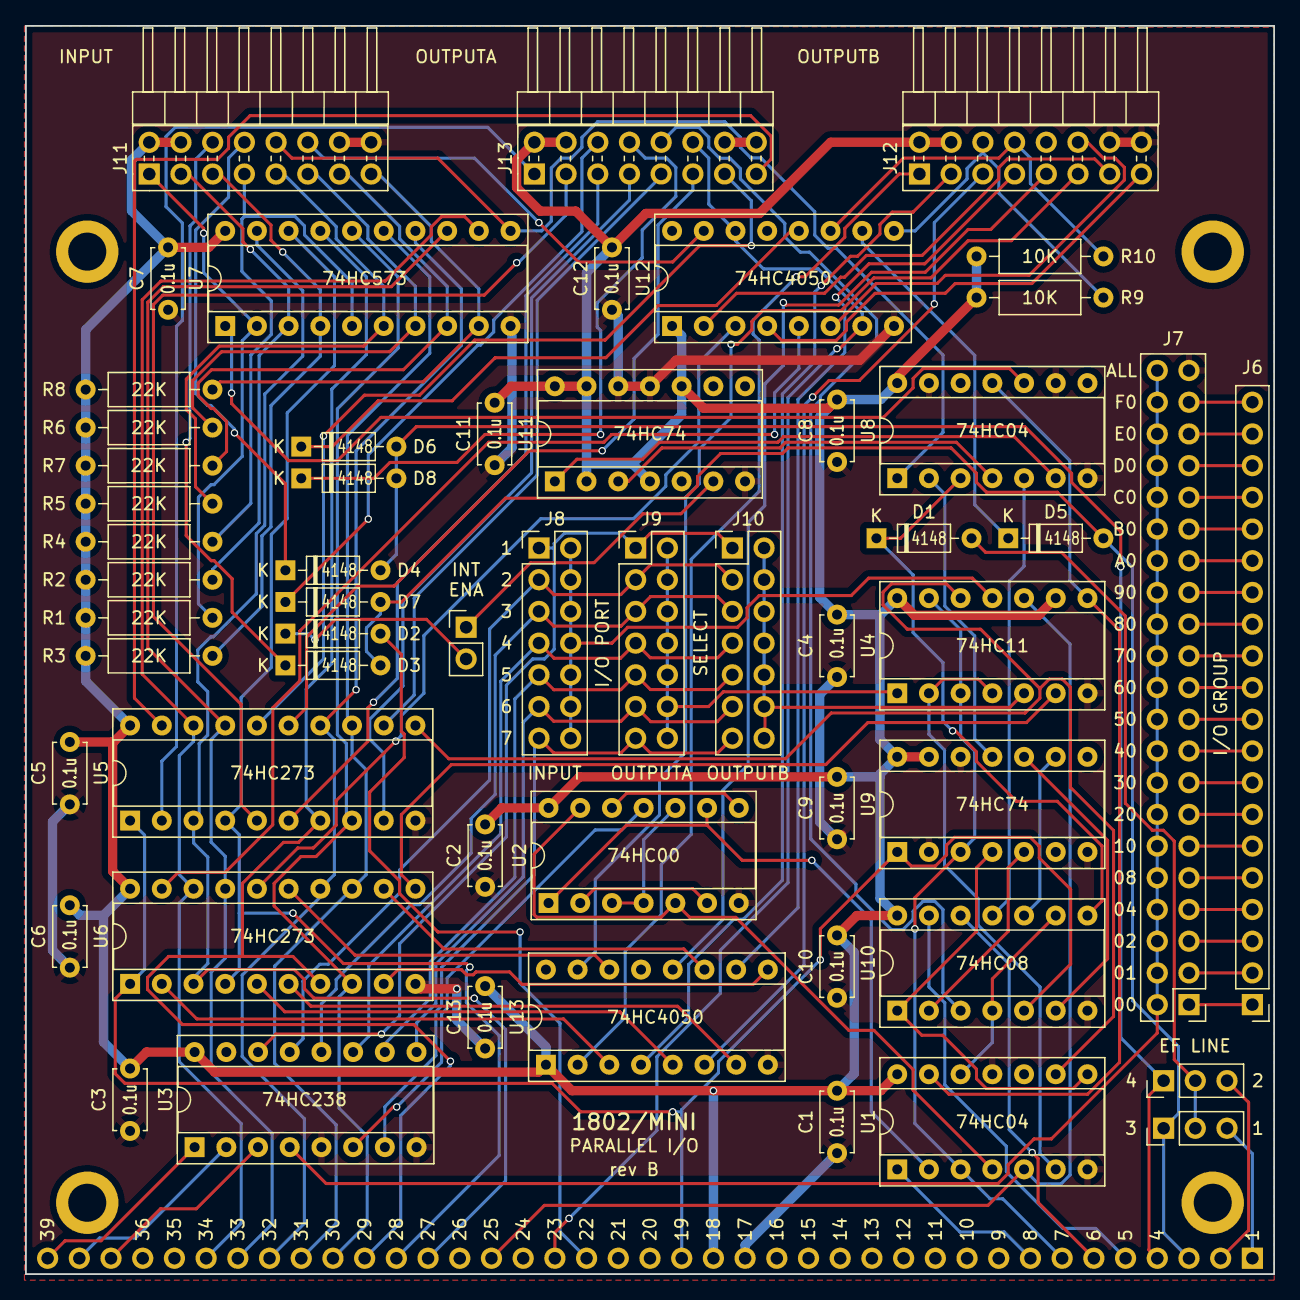
[picture p15: board 1802-Mini-PIO.kicad_pcb from above]

Board: 2 copper layers, 100.0 x 100.0 mm, 60 parts (0 on the bottom side), 124 nets.
