arhefner/1802-Mini-PIO/(commit log)

2022-12-29 Add project files
    [1802-Mini-PIO.kicad_pcb, 1802-Mini-PIO.kicad_sch, 1802-Mini-PIO.sch, input.kicad_sch, n_decoder.kicad_sch, output.kicad_sch, ports.kicad_sch, power.kicad_sch]
2022-12-29 Add pdf of schematic to notes
2023-01-01 Finish Rev A board layout
    [1802-Mini-PIO.kicad_pcb]
2023-01-06 Add BOM to notes
    [1802-Mini-PIO-BOM.xlsx]
2023-04-30 Update to Rev B.
    [1802-Mini-PIO.kicad_pcb, 1802-Mini-PIO.kicad_sch, ports.kicad_sch, power.kicad_sch, service_request.kicad_sch]
2023-05-25 Update pdf schematic to Rev B
